jvSanches/PANDA/Case/Montagem do case.SLDASM

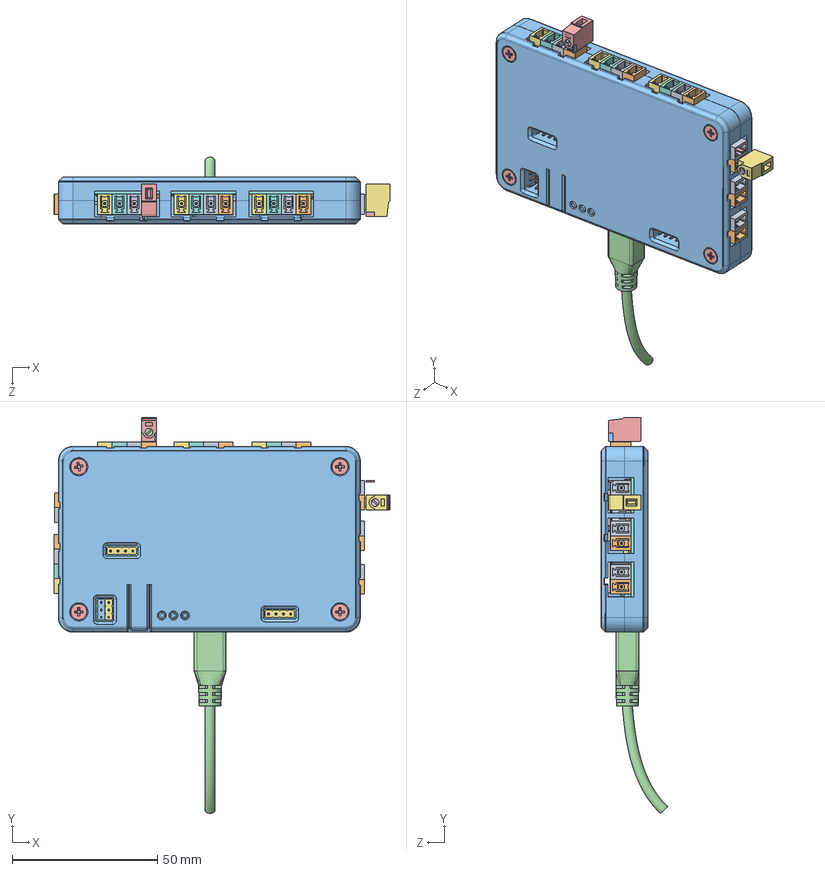
[picture p1: CAD file, 2020-12-04]
Case/Montagem do case.SLDASM
115.6 x 136.4 x 23.0 mm
0603 cap x 28
CAP TANT - 1206 - 1.7MM x 4
SMA x 4
LED 0603 Base BLUE
LED 0603 Base BLUE-1
LED 0603 Lens BLUE
LED 0603 Base GREEN
LED 0603 Base GREEN-1
LED 0603 Lens GREEN
LED 0603 Base RED x 2
LED 0603 Base RED-1 x 2
LED 0603 Lens RED x 2
PinsArrayLR x 2
PinsArrayLR-1 x 2
PinsArrayLR-2 x 2
PinsArrayLR-3 x 2
PinsArrayLR-4 x 2
PinsArrayLR-5 x 2
PinsArrayLR-6 x 2
PinsArrayLR-7 x 2
PinsArrayLR-8
PinsArrayLR-9
PinsArrayLR-10
PinsArrayLR-11
PinsArrayLR-12
PinsArrayLR-13
PinsArrayLR-14
PinsArrayLR-15
PinsArrayLR-16
PinsArrayLR-17
PinsArrayLR-18
PinsArrayLR-19
PinsArrayLR-20
PinsArrayLR-21
PinsArrayLR-22
PinsArrayLR-23
PinsArrayL
PinsArrayL-1
FilletPinR
PinsArrayLR-24
PinsArrayLR-25
PinsArrayLR-26
PinsArrayLR-27
PinsArrayLR-28
PinsArrayLR-29
PinsArrayLR-30
PinsArrayLR-31
contact.stp x 8
body_1pc_1.stp x 4
body_1pc.stp x 4
contact.stp-1 x 16
body_1pc_3.stp x 4
body_1pc_2.stp x 4
body_1pc_1.stp-1 x 4
body_1pc.stp-1 x 4
4 pin vertical header x 2
4 pin vertical header-1 x 2
4 pin vertical header-2 x 2
4 pin vertical header-3 x 2
4 pin vertical header-4 x 2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
