jvSanches/PANDA/Case/Case_01.SLDPRT

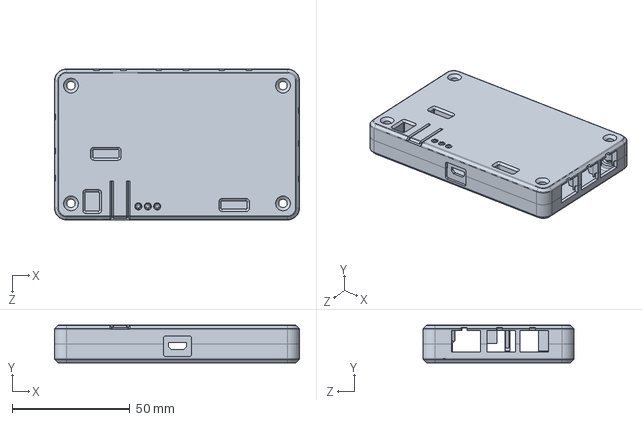
[picture p3: CAD file, 2020-12-04]
Case/Case_01.SLDPRT
104.0 x 16.0 x 64.0 mm
