jvSanches/PANDA/Case/Case_011_fundo.STL

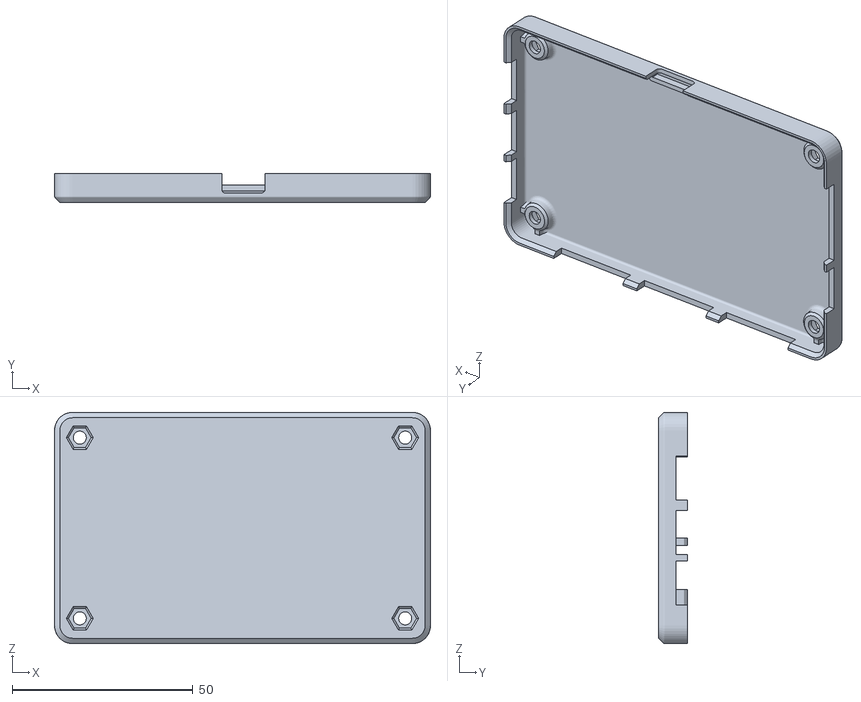
[picture p4: CAD file, 2020-11-14]
Case/Case_011_fundo.STL
104.0 x 8.00 x 64.0
