jvSanches/PANDA/Case/Case_011_tampa.STL

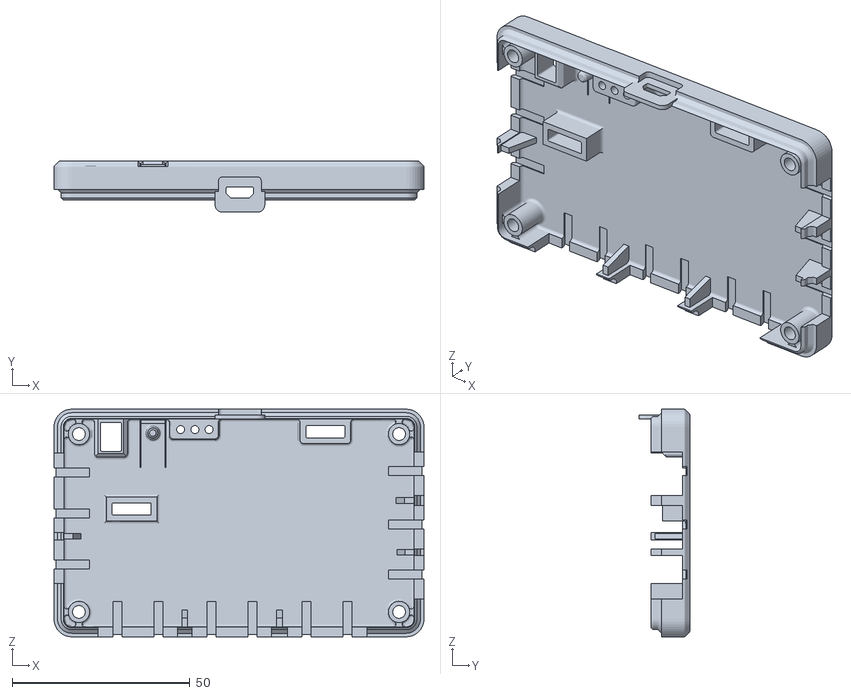
[picture p5: CAD file, 2020-11-14]
Case/Case_011_tampa.STL
104.0 x 14.4 x 64.0
