jvSanches/PANDA/Case/Case_01_tampa.STL

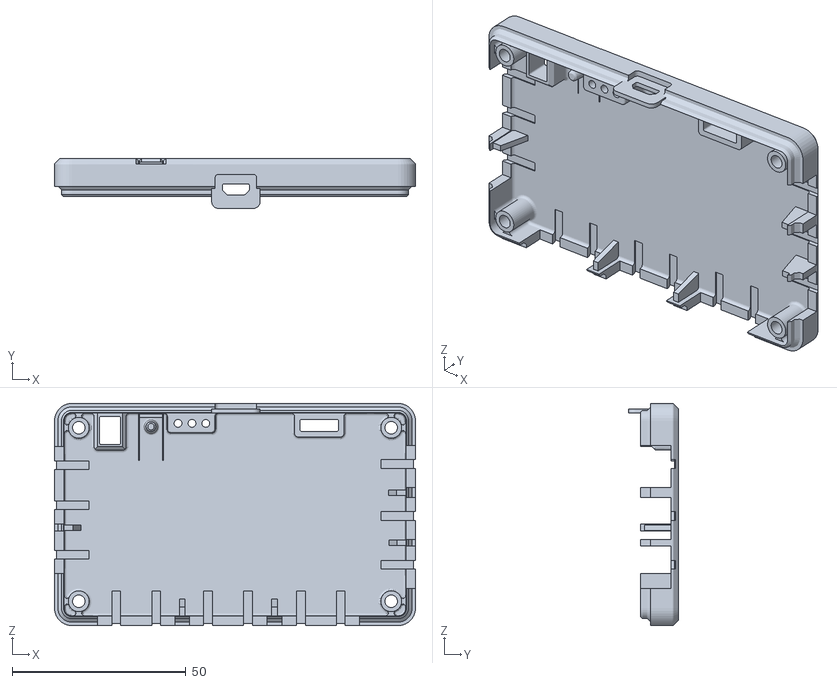
[picture p6: CAD file, 2020-11-11]
Case/Case_01_tampa.STL
104.0 x 14.4 x 64.0
