jvSanches/PANDA/(list of files, cad)

Other CAD files:
Case/Case_01_fundo.STL
