jvSanches/PANDA/Firmware/Testing/configuracao crc.jpg

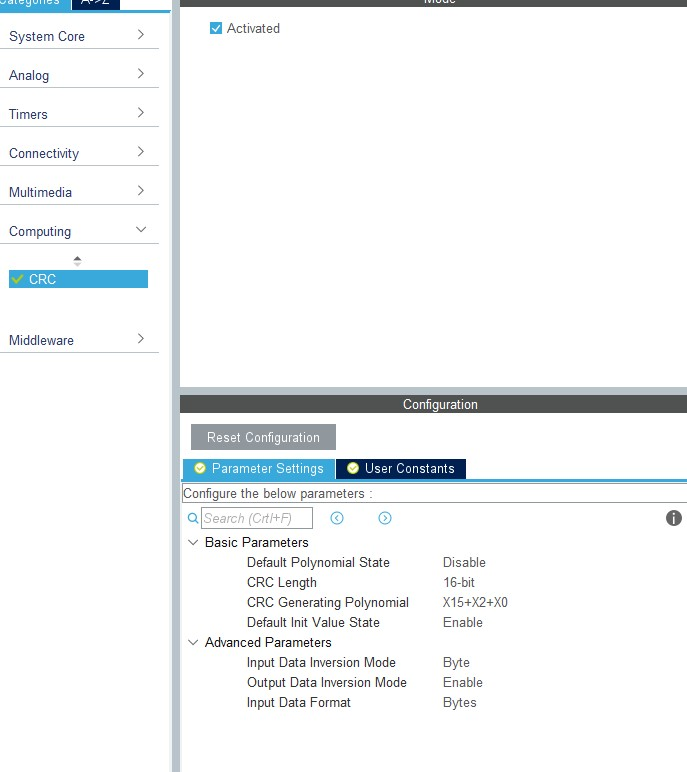
Firmware/Testing/configuracao crc.jpg
