jvSanches/PANDA/Hardware/esquematicoV1.pdf

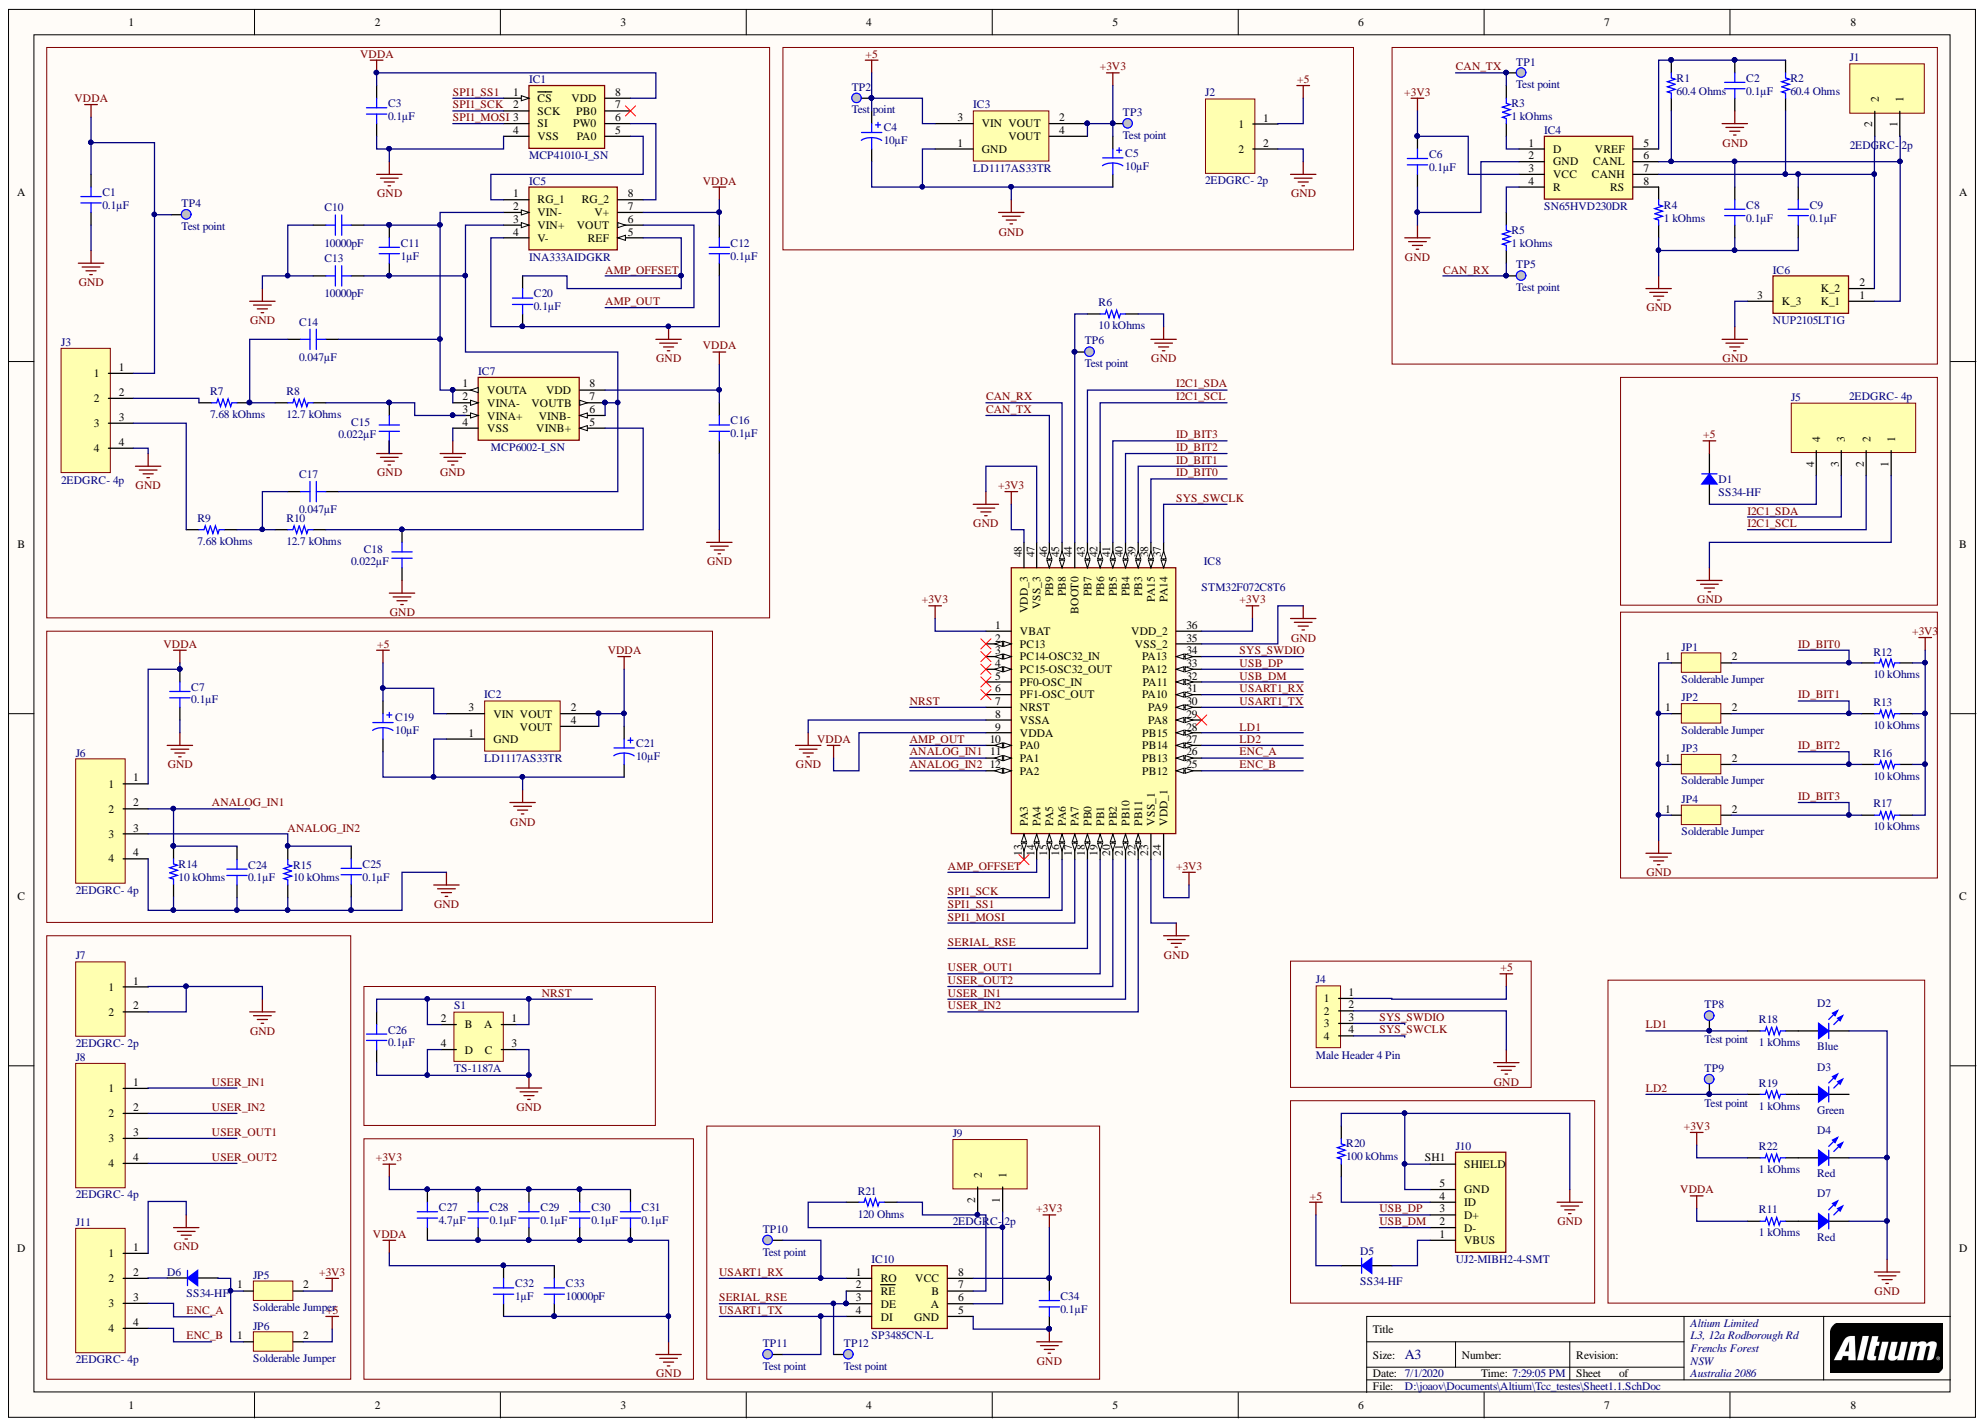
[picture p8: page 1]

ENC_B

Size: A3 | Number: | Revision:

D:\joaov\Documents\Altium\Tcc_testes\Sheet1.1.SchDoc
