jvSanches/PANDA/Firmware/PandaBoard/Panda10/Core/Src/main.c

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
/* Includes ------------------------------------------------------------------*/
#include "main.h"
#include "usb_device.h"

/* USER CODE BEGIN Includes */
#include "spi_devices.h"
#include "outputs.h"
#include "acquisition.h"
#include "panda_usb_device.h"
#include "stm32g4xx_hal_fdcan.h"
/* USER CODE END Includes */

ADC_HandleTypeDef hadc1;
DMA_HandleTypeDef hdma_adc1;

DAC_HandleTypeDef hdac1;

I2C_HandleTypeDef hi2c1;

SPI_HandleTypeDef hspi1;

TIM_HandleTypeDef htim1;
TIM_HandleTypeDef htim3;
TIM_HandleTypeDef htim7;

UART_HandleTypeDef huart2;

/* USER CODE BEGIN PV */
FDCAN_HandleTypeDef hfdcan1;
FDCAN_FilterTypeDef canFilterConfig;
FDCAN_TxHeaderTypeDef canHeaderConfig;
FDCAN_RxHeaderTypeDef RxHeader;
uint8_t rx_data[16];
/* USER CODE END PV */

void SystemClock_Config(void);
static void MX_GPIO_Init(void);
static void MX_DMA_Init(void);
static void MX_SPI1_Init(void);
static void MX_ADC1_Init(void);
static void MX_DAC1_Init(void);
static void MX_I2C1_Init(void);
static void MX_TIM1_Init(void);
static void MX_USART2_UART_Init(void);
static void MX_TIM7_Init(void);
static void MX_TIM3_Init(void);
/* USER CODE BEGIN PFP */
static void MX_FDCAN1_Init(void);
static void CAN_Configure(void);


/* USER CODE END PFP */

/* USER CODE BEGIN 0 */
float counter = 0;
int8_t dir = 1;
uint32_t enc = 0;
uint32_t act_gain = 10;
uint8_t usb_enabled = 1;
uint8_t can_data[3];
/* USER CODE END 0 */

/**
  * @brief  The application entry point.
  * @retval int
  */
int main(void)
{
  /* MCU Configuration--------------------------------------------------------*/

  /* Reset of all peripherals, Initializes the Flash interface and the Systick. */
  HAL_Init();

  /* Configure the system clock */
  SystemClock_Config();

  /* Initialize all configured peripherals */
  MX_GPIO_Init();
  MX_DMA_Init();
  MX_USB_Device_Init();
  MX_SPI1_Init();
  MX_ADC1_Init();
  MX_DAC1_Init();
  MX_I2C1_Init();
  MX_TIM1_Init();
  MX_USART2_UART_Init();
  MX_TIM7_Init();
  MX_TIM3_Init();
  /* USER CODE BEGIN 2 */
  outputsInit(&htim7, &htim3);
  spiInit(&hspi1);
  statusLedBlink();
  acquisitionInit(&hadc1, &htim1, &hdac1);
  setEncoderCount(2048);
  userLedMode(1);



  setGain(200);

  /* USER CODE END 2 */

  /* Infinite loop */
  /* USER CODE BEGIN WHILE */
  while (1)
  {
	usbController();
	userLedController();

	HAL_Delay(20);
	counter = 3.3 * (float)getAnalogRead(2)/ 65536.0;
	enc = getEncoderCount();
	setOffset(enc);
	  if ((usb_enabled == 1) && (HAL_GetTick()>1000)){
		  if (MX_USB_getHost()){
			  usb_enabled = 2;
		  }else{
			  MX_USB_Device_DeInit();
			  usb_enabled = 0;
			  userLedMode(0);
			  MX_FDCAN1_Init();
			  HAL_FDCAN_Start(&hfdcan1);
			  HAL_FDCAN_ActivateNotification(&hfdcan1, FDCAN_IT_RX_FIFO0_NEW_MESSAGE, 0);
			  CAN_Configure();
			  HAL_Delay(500);
			  userLedMode(1);
			  can_data[0] = 55;
			  can_data[1] = 66;
			  HAL_FDCAN_AddMessageToTxFifoQ(&hfdcan1, &canHeaderConfig, can_data);
			  HAL_Delay(500);
			  userLedMode(0);
		  }
	  }
    /* USER CODE END WHILE */

    /* USER CODE BEGIN 3 */
  }
  /* USER CODE END 3 */
}

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
/* USER CODE BEGIN 4 */
void HAL_ADC_ConvCpltCallback(ADC_HandleTypeDef* hadc){

}

/**
  * @brief FDCAN1 Initialization Function
  * @param None
  * @retval None
  */
static void MX_FDCAN1_Init(void)
{

  hfdcan1.Instance = FDCAN1;
  hfdcan1.Init.ClockDivider = FDCAN_CLOCK_DIV1;
  hfdcan1.Init.FrameFormat = FDCAN_FRAME_CLASSIC;
  hfdcan1.Init.Mode = FDCAN_MODE_NORMAL;
  hfdcan1.Init.AutoRetransmission = DISABLE;
  hfdcan1.Init.TransmitPause = DISABLE;
  hfdcan1.Init.ProtocolException = DISABLE;
  hfdcan1.Init.NominalPrescaler = 400;
  hfdcan1.Init.NominalSyncJumpWidth = 1;
  hfdcan1.Init.NominalTimeSeg1 = 13;
  hfdcan1.Init.NominalTimeSeg2 = 2;
  hfdcan1.Init.DataPrescaler = 1;
  hfdcan1.Init.DataSyncJumpWidth = 1;
  hfdcan1.Init.DataTimeSeg1 = 13;
  hfdcan1.Init.DataTimeSeg2 = 2;
  hfdcan1.Init.StdFiltersNbr = 0;
  hfdcan1.Init.ExtFiltersNbr = 0;
  hfdcan1.Init.TxFifoQueueMode = FDCAN_TX_FIFO_OPERATION;
  if (HAL_FDCAN_Init(&hfdcan1) != HAL_OK)
  {
    Error_Handler();
  }
}
void CAN_Configure(){
	canFilterConfig.IdType = FDCAN_STANDARD_ID;
	canFilterConfig.FilterIndex = 0;
	canFilterConfig.FilterType = FDCAN_FILTER_RANGE;
	canFilterConfig.FilterConfig = FDCAN_FILTER_TO_RXFIFO0;
	canFilterConfig.FilterID1 = 0;
	canFilterConfig.FilterID1 = 100;

	if (HAL_FDCAN_ConfigFilter(&hfdcan1, &canFilterConfig) != HAL_OK){
		Error_Handler();
	}

	canHeaderConfig.Identifier = 1;
	canHeaderConfig.IdType = FDCAN_STANDARD_ID;
	canHeaderConfig.TxFrameType = FDCAN_DATA_FRAME;
	canHeaderConfig.DataLength = FDCAN_DLC_BYTES_1;
	canHeaderConfig.ErrorStateIndicator = FDCAN_ESI_PASSIVE;
	canHeaderConfig.BitRateSwitch = FDCAN_BRS_OFF;
	canHeaderConfig.FDFormat = FDCAN_CLASSIC_CAN;
	canHeaderConfig.MessageMarker = 1;

}

void HAL_FDCAN_RxFifo0Callback(FDCAN_HandleTypeDef *hfdcan, uint32_t RxFifo0ITs){

	HAL_FDCAN_GetRxMessage(hfdcan, FDCAN_RX_FIFO0, &RxHeader, rx_data);

}
/* USER CODE END 4 */
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
