jvSanches/PANDA/Firmware/PandaBoard/Panda10/Panda10.ioc

Mcu.UserName=STM32G431KBTx
PA0.GPIO_Label=AMP_OUT
PB0.GPIO_Label=IN2
PB6.GPIO_Label=SPI1_SS2
PA12.Signal=USB_DP
PB6.Signal=GPIO_Output
PF0-OSC_IN.GPIO_Label=IN1
PA10.GPIO_Label=LED_BLUE
PB7.Signal=I2C1_SDA
PA8.Signal=S_TIM1_CH1
PA0.Signal=ADC1_IN1
PA6.Signal=SPI1_MISO
PA10.Signal=GPIO_Output
PA15.Signal=I2C1_SCL
PA4.GPIO_Label=AMP_OFFSET
PF1-OSC_OUT.Signal=GPIO_Output
PB4.Signal=S_TIM3_CH1
PA3.Signal=USART2_RX
PB3.GPIO_Label=LED_GREEN
PA9.GPIO_Label=ENC_CHA
PA13.Signal=SYS_JTMS-SWDIO
PA8.GPIO_Label=ENC_CHB
PA9.Signal=S_TIM1_CH2
PA1.Signal=USART2_DE
PA5.Signal=SPI1_SCK
PF1-OSC_OUT.GPIO_Label=SPI1_SS1
PA2.Signal=USART2_TX
PB3.Signal=GPIO_Output
PA4.Signal=COMP_DAC11_group
PB5.Signal=S_TIM3_CH2
PA11.Signal=USB_DM
PA14.Signal=SYS_JTCK-SWCLK
PF0-OSC_IN.Signal=ADC1_IN10
PB0.Signal=ADC1_IN15
PA7.Signal=SPI1_MOSI
