jvSanches/PANDA/Firmware/PandaBoard/Panda10_CAN/Core/Inc/main.h

#define IN1_Pin GPIO_PIN_0
#define IN1_GPIO_Port GPIOF
#define SPI1_SS1_Pin GPIO_PIN_1
#define SPI1_SS1_GPIO_Port GPIOF
#define AMP_OUT_Pin GPIO_PIN_0
#define AMP_OUT_GPIO_Port GPIOA
#define AMP_OFFSET_Pin GPIO_PIN_4
#define AMP_OFFSET_GPIO_Port GPIOA
#define IN2_Pin GPIO_PIN_0
#define IN2_GPIO_Port GPIOB
#define ENC_CHB_Pin GPIO_PIN_8
#define ENC_CHB_GPIO_Port GPIOA
#define ENC_CHA_Pin GPIO_PIN_9
#define ENC_CHA_GPIO_Port GPIOA
#define LED_BLUE_Pin GPIO_PIN_10
#define LED_BLUE_GPIO_Port GPIOA
#define LED_GREEN_Pin GPIO_PIN_3
#define LED_GREEN_GPIO_Port GPIOB
#define SPI1_SS2_Pin GPIO_PIN_6
#define SPI1_SS2_GPIO_Port GPIOB
