jvSanches/PANDA/Software/Panda Terminal/panda_board.py

#----------------------------------------------------------------------

# Software da PANDA
# TCC - Engenharia Mecatrônica - Poli USP
# Guilherme de Agrela Lopes
# João Vitor Sanches
#
# PANDA BOARD INTERFACE
#
# Arquivos:
# MainFrame: Tela principal; chamada das outras classes
# CalibrationFrame: Tela para realizar a calibração da placa; criada ao clicar no botão 'Modo de Calibração' da tela principal
# PlotFrame: Telas com os gráficos gerados a partir das seleções na tela de Configuração; criadas ao clicar no botão 'Mostrar Gráficos'
# SettingsFrame: Tela para escolher as configurações desejadas do programa; criada ao clicar no botão 'Configurações'
# PandaDialogs: Diálogos de erro relacionados com a PANDA
# panda_board: Interação do software com o firmware da PANDA

#----------------------------------------------------------------------

import serial
import serial.tools.list_ports
import struct
from time import sleep
from datetime import datetime
import matplotlib.pyplot as plt
import queue
import numpy as np
DEVICE_INQUIRE_TIMEOUT = 0.5


def getPandaPorts():
    ports = [str(i).split()[0] for i in serial.tools.list_ports.comports()]
    
    pandas = []
    for portname in ports:
        try:
            device = serial.Serial(portname, baudrate = 57600, write_timeout=0.2)
            sleep(0.5)
            device.write([35, 1, 1, 13, 10])
            sleep(0.1)
            answer = []
            scanstart = datetime.now()
            timeout = 0        
            while device.in_waiting > 0 and not timeout:
                
                timeout = (datetime.now() - scanstart).total_seconds() > DEVICE_INQUIRE_TIMEOUT
                answer = (device.read(device.in_waiting))
            if(b'I am a Panda' in answer):            
                pandas.append(portname)      
                    
            device.close()
        except:
            pass
    return pandas


class panda:
    def send(self, data):
        if (self.board):
            le = len(data)
            msg  = [35, le] + data + [13, 10]
            self.board.write(msg)
            #print("sent: ", [i for i in msg])
        else:
            print("Serial port not Configured")
    def parseFrame(self):
        frame = []
        timeout = 0.1
        start_byte = 0
        expected_len = 0
        actual_len = 0
        end_of_frame = 0
        state = 0 # 0 start / 1 check len / 2 listening / 3 eof
        parse_start = datetime.now()
        _timeout = 0
        while not end_of_frame and not _timeout and self.board.in_waiting != 0:
            _timeout = (datetime.now() - parse_start).total_seconds() > timeout
            data = int.from_bytes(self.board.read(), 'big')
            if data >= 0 and data <= 255:
                if state == 0:
                    if data == ord('#'):
                        state = 1
                        frame.append(data)
                    else:
                        break
                elif state == 1:
                    expected_len = data
                    state = 2
                    frame.append(data)
                elif state == 2:
                    actual_len += 1
                    frame.append(data)
                    if actual_len == expected_len:
                        state = 3
                elif state == 3:
                    if data == ord('\r'):
                        frame.append(data)
                        state = 4
                    else:
                        break
                elif state == 4:
                    if data == ord('\n'):
                        frame.append(data)
                        return frame 
                    else:
                        break
        print("Reception fault")  
        return None             


    def receive(self):
        lines = []      

        while self.board.in_waiting > 0:
            lines.append(self.parseFrame())
        if lines:
            if len(lines) > 1:
                print("Unexpected lines received")
                input()
            
            #for line in lines:
                #print("Received: ", [i for i in line])
            return lines[-1]
        else:
            return 0

    def waitAck(self, timeout = 0.1):
        wait_start = datetime.now()
        _timeout = 0
        while self.board.in_waiting == 0 and not _timeout:
            _timeout = (datetime.now() - wait_start).total_seconds() > timeout
            if _timeout:
                print("Ack timeout")

        msg = self.receive() 
        if msg:
            return msg
        else:
            print("Panda didn't answer last call")
            return 0

    def __init__(self, port, id = None):
        if port == 'auto':
            available_pandas = getPandaPorts()
            self.board = 0
            if available_pandas:
                self.board = serial.Serial(available_pandas[0], baudrate = 57600, timeout = 0.2)
                self.send([10, 2])
                self.waitAck()
                self.send([12, 20])
                self.waitAck()
                self.send([5, 1])
                self.waitAck()
                sleep(0.5)
                self.send([10, 0])
                self.waitAck()
                print("Panda Connected")
                #print(available_pandas)
                
            else:
                print("No pandas available...")
                quit()

    def exists(self):
        if self.board != 0:
            return True
        else:
            return False
                
    def disconnect(self):
        if self.board:
            self.send([5, 0])
            self.waitAck()
            self.send([10, 2])
            self.waitAck()
            self.send([12, 20])
            self.waitAck()
            sleep(0.5)
            self.send([10, 0])
            self.waitAck()
            self.board.close()
            print("Panda Disconnected")
        
    def setLedMode(self, state):
        if state == "OFF" or state == 0:
            self.send([10,0])
        elif state == "ON" or state == 1:
            self.send([10,1])
        elif state == "BLINK" or state == 2:
            self.send([10,2])        
        return bool(self.waitAck())

    def setLedFreq(self, freq):
        if freq > 100 or freq < 1:
            print("Frequency out of bounds")
            return 0
        freq = int(freq)
        self.send([12,freq])
        return bool(self.waitAck())

    def setOut1(self, state):
        if state == "OFF" or state == 0:
            self.send([14,0])
        elif state == "ON" or state == 1:
            self.send([14,1])
        return bool(self.waitAck())

    def setOut2(self, state):
        if state == "OFF" or state == 0:
            self.send([16,0])
        elif state == "ON" or state == 1:
            self.send([16,1])
        return bool(self.waitAck())

    def getAmpValue(self):
        self.send([20])
        response = self.waitAck()
        if response[2] == 148:
            value = (response[3]<<8) + (response[4])
            return value
        else:
            print("wrong response code")
            return None

    def getAnalog1(self):
        self.send([21])
        response = self.waitAck()
        if response[2] == 149:
            value = (response[3]<<8) + (response[4])
            return value
        else:
            print("wrong response code")
            return None
            
    def getAnalog2(self):
        self.send([22])
        response = self.waitAck()
        if response[2] == 150:
            value = (response[3]<<8) + (response[4]) 
            return value
        else:
            print("wrong response code")
            return None

    def getIn1(self):
        self.send([30])
        response = self.waitAck()
        if response[2] == 158:
            value = response[3]
            return value
        else:
            print("wrong response code")
            return None
    def getIn2(self):
        self.send([31])
        response = self.waitAck()
        if response[2] == 159:
            value = response[3]
            return value
        else:
            print("wrong response code")
            return None
    
    def setEncoderMode(self, mode):
        if mode == "QUADRATURE" or mode == 0:
            self.send([40,0])
        elif mode == "PWM" or mode == 1:
            self.send([40,1])
        return bool(self.waitAck())

    def setEncoderCount(self, count):
        if count < 0 or count > 2**32:
            print("Invalid count")
            return 0            
        self.send([42]+list(struct.unpack('4B', struct.pack('>I', count))))
        return bool(self.waitAck())
    
    def getEncoderCount(self):
        self.send([43])
        response = self.waitAck()
        if response[2] == 171:
            value = (response[3]<<24) + (response[4]<<16) + (response[5]<<8) + response[6]
            return value
        else:
            print("wrong response code")
            return None

    def getEncoderDuty(self):
        self.send([44])
        response = self.waitAck()
        if response[2] == 172:
            value = (response[3]<<8) + (response[4])
            return value
        else:
            print("wrong response code")
            return None

    def runAutoOffset(self, zero_value = 2048):
        if zero_value < 0 or zero_value  > 4095:
            print("Invalid Offset")
            return 0    
        self.send([62]+list(struct.unpack('2B', struct.pack('>h', zero_value))))
        return bool(self.waitAck(2))#Reduzir timeout depois

    def setGain(self, gain):
        if gain < 1:
            print("Invalid gain")
            return 0    
        self.send([54]+list(struct.unpack('2B', struct.pack('>h', gain))))
        ack = self.waitAck(1) #Reduzir timeout depois
        #print((ack[3]<<8) + (ack[4]))
        return bool(ack)

class monitor:
    def __init__(self, timestep, samples = 50, y_label = 'Value'):
        self.x_vec = np.linspace(-samples*timestep ,-timestep, samples)
        self.timestep = timestep
        self.samples = samples
        self.curve_legends = []
        self.curve_getters = []
        self.curves = []
        plt.ion()
        self.fig = plt.figure(figsize=(13,6))
        self.ax = self.fig.add_subplot(111)
        self.hists = []        
        self.curve_colors = ['b','g','r','c','m','y']
        self.y_label = y_label
        

    def addCurve(self, c_name, c_getter):
        self.curve_getters.append(c_getter)
        self.curve_legends.append(c_name)

        y_hist = queue.Queue()
        for i in range(self.samples):
            y_hist.put(0)
        self.hists.append(y_hist)

        y_vec = np.zeros(self.samples)
        curve_, = self.ax.plot(self.x_vec, y_vec, self.curve_colors[len(self.curves)])
        self.curves.append(curve_)

    def start(self):
        plt.xlabel('Time [s]')
        plt.ylabel(self.y_label)
        plt.title('Monitor')
        plt.show()
        plt.grid()
        plt.legend(self.curve_legends)

    def update(self):
        for curve_n in range(len(self.curves)):            
            self.hists[curve_n].get()
            n_value = self.curve_getters[curve_n]()
            self.hists[curve_n].put(n_value)
            y_vec = list(self.hists[curve_n].queue)
            self.curves[curve_n].set_ydata(y_vec)
            
        min_y = min([min(i.queue) for i in self.hists])
        max_y = max([max(i.queue) for i in self.hists])
        marg = 0.1*(max_y - min_y)
        
        plt.ylim([min_y-marg, max_y+marg])
        plt.pause(self.timestep)

    def stop(self):
        plt.ioff()
    
    def resume(self):
        plt.ion()
