jvSanches/PANDA/Firmware/Testing/Disco/Core/Src/main.c

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
/* Includes ------------------------------------------------------------------*/
#include "main.h"
#include "usb_device.h"

/* USER CODE BEGIN Includes */
#include "acquisition.h"
#include "outputs.h"
#include "panda_usb_device.h"
/* USER CODE END Includes */

ADC_HandleTypeDef hadc;
DMA_HandleTypeDef hdma_adc;

SPI_HandleTypeDef hspi1;

TIM_HandleTypeDef htim2;
TIM_HandleTypeDef htim14;

void SystemClock_Config(void);
static void MX_GPIO_Init(void);
static void MX_DMA_Init(void);
static void MX_TIM14_Init(void);
static void MX_ADC_Init(void);
static void MX_TIM2_Init(void);
static void MX_SPI1_Init(void);
/* USER CODE BEGIN 0 */
void spiTransmit(){
	HAL_GPIO_WritePin(SPI1_SS1_GPIO_Port, SPI1_SS1_Pin, 0);
	HAL_Delay(5);
	uint8_t pData[5];
	pData[0] = 55;
	HAL_SPI_Transmit(&hspi1,pData, 1, 50);
	HAL_Delay(5);
	HAL_GPIO_WritePin(SPI1_SS1_GPIO_Port, SPI1_SS1_Pin, 1);
}
/* USER CODE END 0 */

/**
  * @brief  The application entry point.
  * @retval int
  */
int main(void)
{
  /* MCU Configuration--------------------------------------------------------*/

  /* Reset of all peripherals, Initializes the Flash interface and the Systick. */
  HAL_Init();

  /* Configure the system clock */
  SystemClock_Config();

  /* Initialize all configured peripherals */
  MX_GPIO_Init();
  MX_DMA_Init();
  MX_TIM14_Init();
  MX_USB_DEVICE_Init();
  MX_ADC_Init();
  MX_TIM2_Init();
  MX_SPI1_Init();
  /* USER CODE BEGIN 2 */



  usb_init();
  outputsInit(&htim14);
  acquisitionInit(&hadc, &htim2);
  statusLedBlink();
  HAL_GPIO_WritePin(SPI1_SS1_GPIO_Port, SPI1_SS1_Pin, 1);



  /* USER CODE END 2 */

  /* Infinite loop */
  /* USER CODE BEGIN WHILE */
  while (1)
  {
	  usbController();
	  userLedController();
	  if(HAL_GPIO_ReadPin(B1_GPIO_Port, B1_Pin)){
		  spiTransmit();
		  HAL_Delay(500);
	  }


    /* USER CODE END WHILE */

    /* USER CODE BEGIN 3 */
  }
  /* USER CODE END 3 */
}

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
/* USER CODE BEGIN 4 */
void HAL_GPIO_EXTI_Callback(uint16_t GPIO_Pin)
{
  if(GPIO_Pin == ENC_A_Pin || GPIO_Pin == ENC_B_Pin){
	  encoderController();
  }




}
/* USER CODE END 4 */
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
