jvSanches/PANDA/Firmware/PandaBoard/Panda10_CAN/Core/Inc/panda_utils.h

/*
 * panda_utils.h
 *
 *  Created on: Nov 4, 2020
 *      Author: joaov
 */

#ifndef INC_PANDA_UTILS_H_
#define INC_PANDA_UTILS_H_

#include "main.h"



//Utils functions
uint8_t get8MSB(uint16_t val);
uint8_t get8LSB(uint16_t val);
uint16_t get16MSB(uint32_t val);
uint16_t get16LSB(uint32_t val);



#endif /* INC_PANDA_UTILS_H_ */
