jvSanches/PANDA/Software/Panda Terminal/CalibrationFrame.py

#----------------------------------------------------------------------

# Software da PANDA
# TCC - Engenharia Mecatrônica - Poli USP
# Guilherme de Agrela Lopes
# João Vitor Sanches
#
# MAIN FRAME
#
# Arquivos:
# MainFrame: Tela principal; chamada das outras classes
# CalibrationFrame: Tela para realizar a calibração da placa; criada ao clicar no botão 'Modo de Calibração' da tela principal
# PlotFrame: Telas com os gráficos gerados a partir das seleções na tela de Configuração; criadas ao clicar no botão 'Mostrar Gráficos'
# SettingsFrame: Tela para escolher as configurações desejadas do programa; criada ao clicar no botão 'Configurações'
# PandaDialogs: Diálogos de erro relacionados com a PANDA
# panda_board: Interação do software com o firmware da PANDA

#----------------------------------------------------------------------

import wx

class CalibrationFrame(wx.Frame):
    """
    This is the Calibration Frame.  It shows the options of calibration for the user to choose.
    The value is sent to the PANDA board and it's DAC does the calibration procedure.
    """
    def __init__(self, calibration, parent, title):
        wx.Frame.__init__(self, parent, -1, title,
                          pos=(350, 250), size=(600, 350))

        # Creates the Panel to put the other controls on
        self.panel = wx.Panel(self)

        # Initializes calibration array
        self.calibration = calibration

        # Controls
        self.text = wx.StaticText(self.panel, -1, label="Digite o valor de deformação, força ou torque aplicado.", pos=(15, 15))
        self.text.SetFont(wx.Font(12, wx.SWISS, wx.NORMAL, wx.BOLD))
        self.text.SetSize(self.text.GetBestSize())

        self.btn_optStrain = wx.RadioButton(self.panel, -1, label="Deformação", style=wx.RB_GROUP, pos=(15, 95))
        self.btn_optForce = wx.RadioButton(self.panel, -1, label="F/T", pos=(210, 95))
        self.btn_optStress = wx.RadioButton(self.panel, -1, label="Tensão", pos=(375, 95))
        
        self.btn_strainValue = wx.SpinCtrl(self.panel, value='0', pos=(110, 90), min=0, max=1000)
        self.btn_forceValue = wx.SpinCtrl(self.panel, value='0', pos=(270, 90), min=0, max=1000)
        self.btn_stressValue = wx.SpinCtrl(self.panel, value='0', pos=(440, 90), min=0, max=1000)
        
        self.btn_confirmChoices = wx.Button(self.panel, -1, label="Aplicar", pos=(140, 200))
        self.btn = wx.Button(self.panel, -1, "Cancelar", pos=(340, 200))

        # Binds the controls to handlers
        self.Bind(wx.EVT_BUTTON, self.OnTimeToClose, self.btn)
        self.Bind(wx.EVT_RADIOBUTTON, self.SelectStrain, self.btn_optStrain)
        self.Bind(wx.EVT_RADIOBUTTON, self.SelectForce, self.btn_optForce)
        self.Bind(wx.EVT_RADIOBUTTON, self.SelectStress, self.btn_optStress)
        self.Bind(wx.EVT_BUTTON, self.OnConfirmButton, self.btn_confirmChoices)

        # Prepares the Frame, based on calibration array values
        if self.calibration[0]:
            self.btn_strainValue.Enable()
        else:
            self.btn_strainValue.Disable()
        if self.calibration[1]:
            self.btn_forceValue.Enable()
        else:
            self.btn_forceValue.Disable()
        if self.calibration[2]:
            self.btn_stressValue.Enable()
        else:
            self.btn_stressValue.Disable()
        self.btn_optStrain.SetValue(self.calibration[0])
        self.btn_optForce.SetValue(self.calibration[1])
        self.btn_optStress.SetValue(self.calibration[2])
        self.btn_strainValue.SetValue(self.calibration[3])
        self.btn_forceValue.SetValue(self.calibration[4])
        self.btn_stressValue.SetValue(self.calibration[5])

        self.panel.Layout()


    def SelectStrain(self, evt):
        """Event handler for the Strain Radio Button."""
        self.btn_strainValue.Enable()
        self.btn_forceValue.Disable()
        self.btn_stressValue.Disable()


    def SelectForce(self, evt):
        """Event handler for the Force/Torque Radio Button."""
        self.btn_strainValue.Disable()
        self.btn_forceValue.Enable()
        self.btn_stressValue.Disable()


    def SelectStress(self, evt):
        """Event handler for the Stress Radio Button."""
        self.btn_strainValue.Disable()
        self.btn_forceValue.Disable()
        self.btn_stressValue.Enable()


    def OnConfirmButton(self, evt):
        """Event handler for the Confirm button."""
        # Attributes new values to calibration array
        self.calibration[0] = self.btn_optStrain.GetValue()
        self.calibration[1] = self.btn_optForce.GetValue()
        self.calibration[2] = self.btn_optStress.GetValue()
        self.calibration[3] = self.btn_strainValue.GetValue()
        self.calibration[4] = self.btn_forceValue.GetValue()
        self.calibration[5] = self.btn_stressValue.GetValue()
        self.calibration[6] = wx.ID_OK

        self.Close()


    def OnTimeToClose(self, evt):
        """Event handler for closing."""
        self.Close()
        

    def GetCal(self):
        """Returns calibration array when asked."""
        return self.calibration
