jvSanches/PANDA/(commit log)

2020-07-01 Initial testing with discovery board
2020-07-01 Add case 3d model files
    [2EDGR - 2P.STEP, 2EDGR - 4P.STEP, 4 pin vertical header.STEP, Assem1.SLDASM, CUI_DEVICES_UJ2-MIBH2-4-SMT.step, Case.SLDPRT, PCB1.SLDASM, PCB1.step]
2020-07-01 add schematic circuit drawing
2020-10-23 add disco project for testing purposes
    [2EDGR - 2P.STEP, 2EDGR - 4P.STEP, 4 pin vertical header.STEP, Assem1.SLDASM, CUI_DEVICES_UJ2-MIBH2-4-SMT.step, Case.SLDPRT, Case_01.SLDPRT, Case_01_fundo.STL]
2020-11-11 general updates
    [Case_01.SLDPRT, Case_01_fundo.STL, Case_01_tampa.STL, Function list.xlsx]
2020-11-12 fixed minor usb protocol issues
    [Function list.xlsx]
2020-11-13 Fixed class methods naming
    [panda_board.py]
2020-11-14 Added frame parser to panda class
2020-11-14 Add a case version with openings for programming
    [Case_01.SLDPRT, Case_011_fundo.STL, Case_011_tampa.STL, Montagem do case.SLDASM, PCB1a2.SLDASM]
2020-11-18 Semifinal Version - Missing Comments
    [CalibrationFrame.py, MainFrame.py, PlotFrame.py, SettingsFrame.py]
2020-11-20 Fixed some issues with calibration and gain
    [CalibrationFrame.py, MainFrame.py, SettingsFrame.py]
2020-12-04 Changed demo parameter for better mass values
    [Case_01.SLDPRT, Montagem do case.SLDASM, PCB1a2.SLDASM]
2020-12-06 Fixed library getting stuck on some serial ports
    [Blue_pill.ioc, PlotFrame.py, main.c, panda_board.py]
2021-06-12 add device configuration for board version 1.0
2021-06-16 adds pwm output to firmware
2021-06-30 Fixed pwm related functions
    [main.c, outputs.c, outputs.h, panda_usb_device.c]
